RotorHazard/rhfiles/6_Node_BPill/case/img/RH_Lid_Wiring.jpg

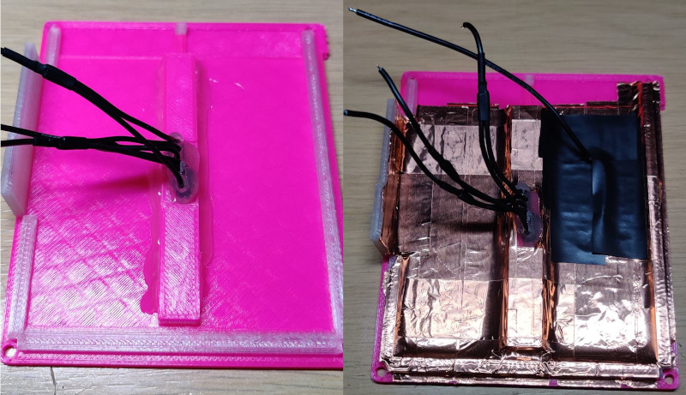
6_Node_BPill/case/img/RH_Lid_Wiring.jpg
