RotorHazard/rhfiles/S32_BPill/caseBuildPics/image006.jpg

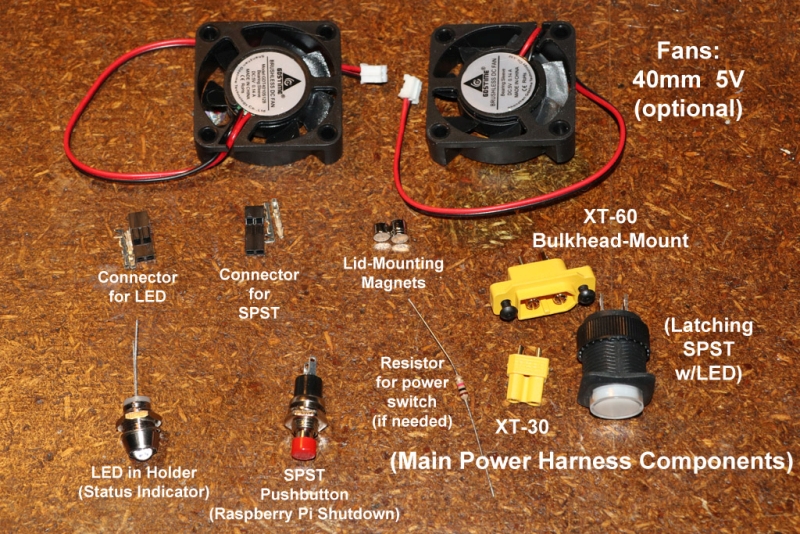
S32_BPill/caseBuildPics/image006.jpg
