RotorHazard/rhfiles/6_Node_BPill/case/img/RH_Cartridge_Slot.jpg

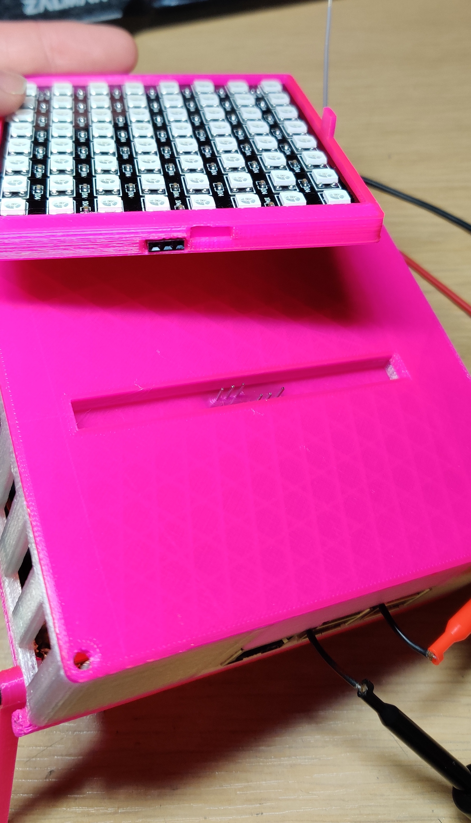
6_Node_BPill/case/img/RH_Cartridge_Slot.jpg
