RotorHazard/rhfiles/6_Node_BPill/case/img/RH_Case_Fold_Up.jpg

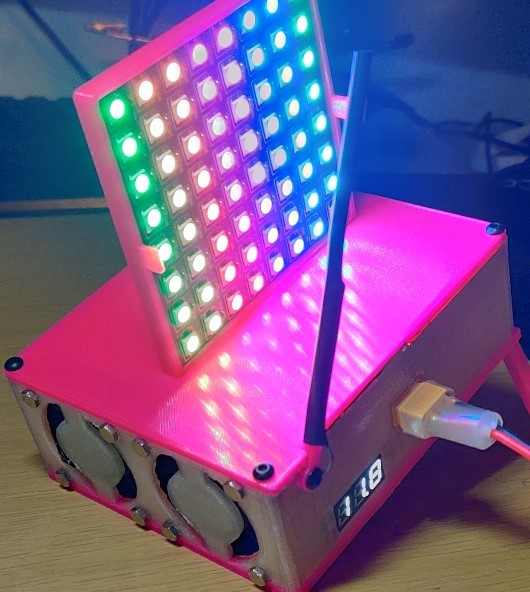
6_Node_BPill/case/img/RH_Case_Fold_Up.jpg
