RotorHazard/rhfiles/6_Node_BPill/case/img/RH_Case_Screen.jpg

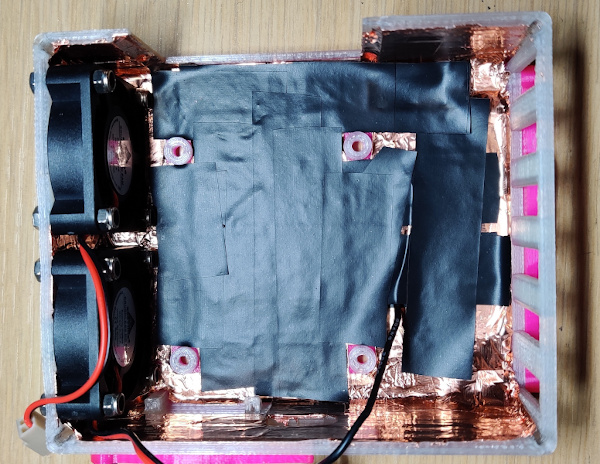
6_Node_BPill/case/img/RH_Case_Screen.jpg
