RotorHazard/rhfiles/6_Node_BPill/case/img/RH_Inside.jpg

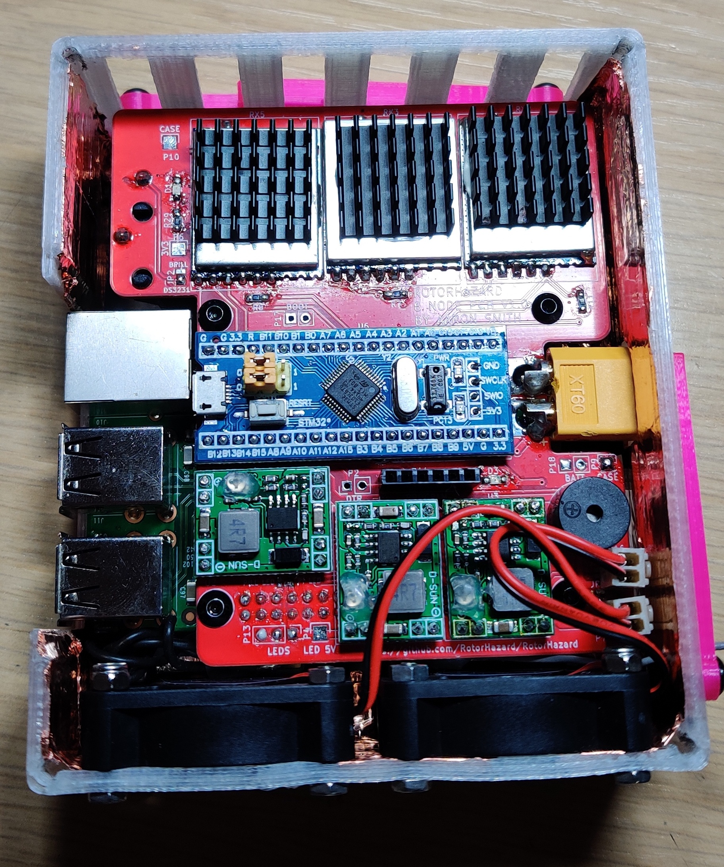
6_Node_BPill/case/img/RH_Inside.jpg
