RotorHazard/rhfiles/6_Node_BPill/case/img/RH_LED_Cartridge.jpg

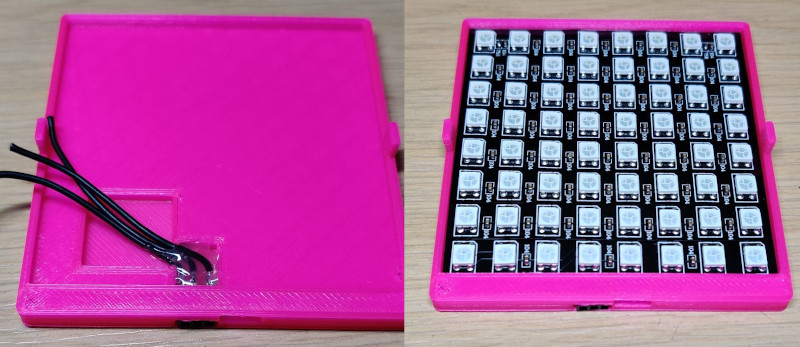
6_Node_BPill/case/img/RH_LED_Cartridge.jpg
