RotorHazard/rhfiles/6_Node_BPill/case/img/Wifi_Module.jpg

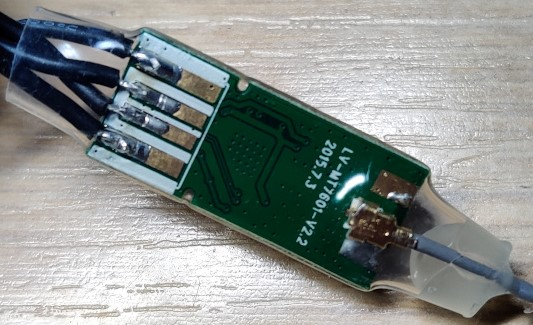
6_Node_BPill/case/img/Wifi_Module.jpg
