RotorHazard/rhfiles/S32_BPill/stm32f4pics/stm32f4_mod3.jpg

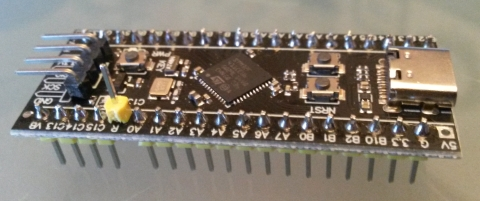
S32_BPill/stm32f4pics/stm32f4_mod3.jpg
