RotorHazard/rhfiles/6_Node_BPill/case/stl/RotorHazard_Standoff_M3_13.1mm.stl

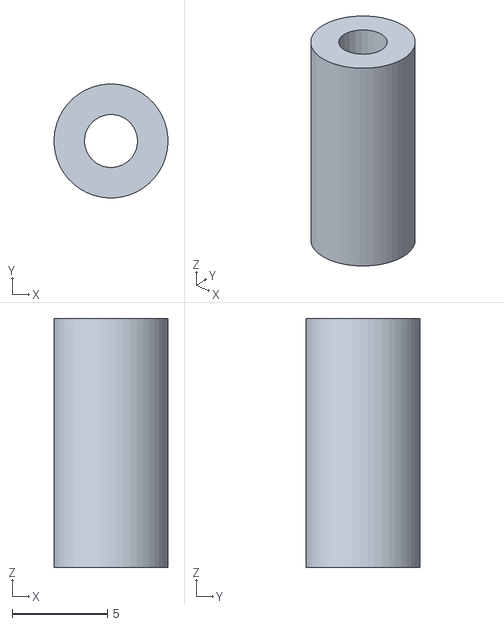
[picture p17: CAD file, 2021-04-22]
6_Node_BPill/case/stl/RotorHazard_Standoff_M3_13.1mm.stl
5.99 x 5.99 x 13.1
