RotorHazard/rhfiles/S32_BPill/case/RotorHazardCaseTopBDyy.stl

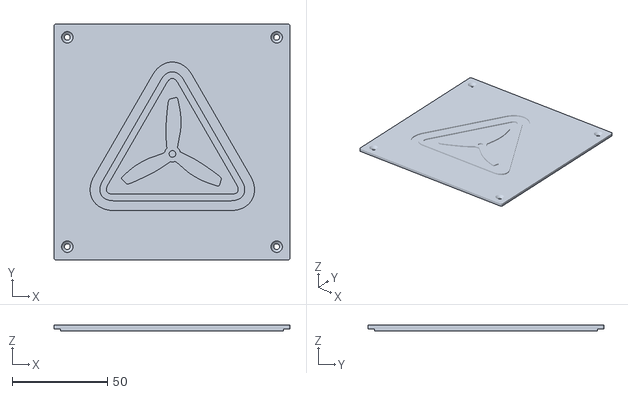
[picture p18: CAD file, 2021-02-14]
S32_BPill/case/RotorHazardCaseTopBDyy.stl
124.0 x 124.0 x 3.00
