RotorHazard/rhfiles/6_Node_BPill/case/stl/RotorHazard_Case - pi zero.stl

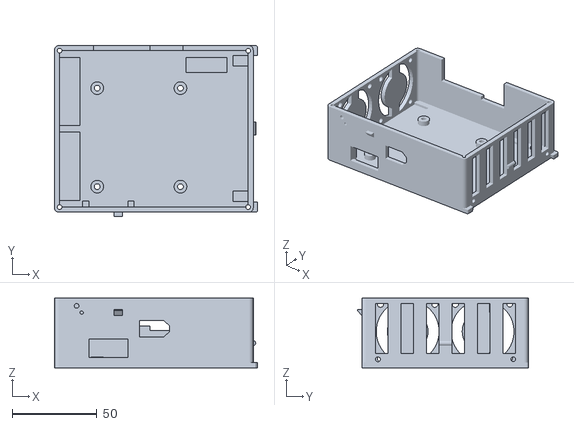
[picture p19: CAD file, 2021-04-22]
6_Node_BPill/case/stl/RotorHazard_Case - pi zero.stl
119.5 x 100.6 x 41.0
