RotorHazard/rhfiles/S32_BPill/case/RotorHazardCaseBDyy.FCStd

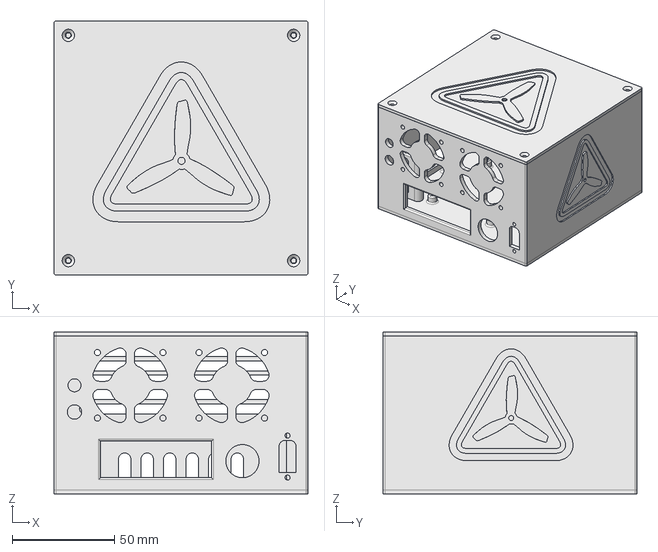
[picture p20: CAD file, 2021-02-14]
S32_BPill/case/RotorHazardCaseBDyy.FCStd
124.0 x 124.0 x 79.0 mm
CaseTop
