RotorHazard/rhfiles/6_Node_BPill/case/stl/RotorHazard_Antenna_Holder_50mm.stl

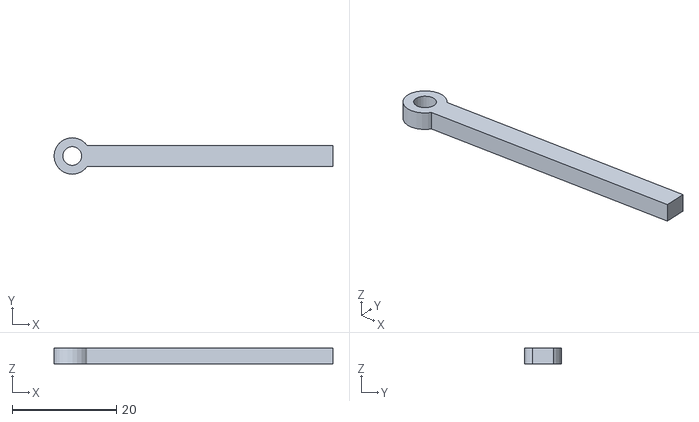
[picture p21: CAD file, 2021-03-14]
6_Node_BPill/case/stl/RotorHazard_Antenna_Holder_50mm.stl
53.5 x 7.00 x 3.00
