RotorHazard/rhfiles/6_Node_BPill/case/stl/RotorHazard_Standoff_M2.5_11.5mm.stl

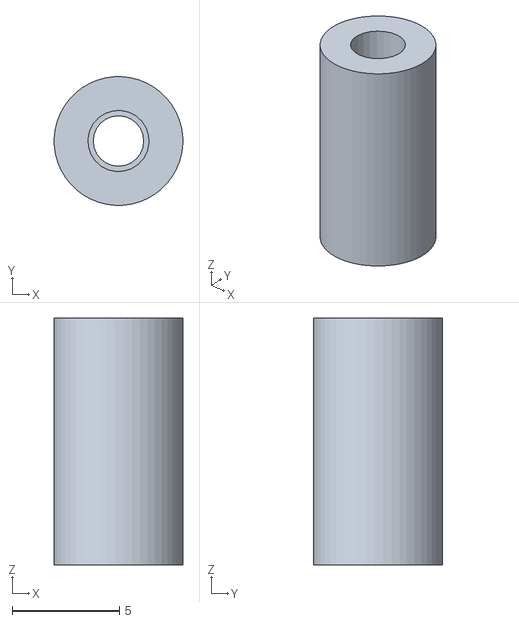
[picture p22: CAD file, 2021-03-14]
6_Node_BPill/case/stl/RotorHazard_Standoff_M2.5_11.5mm.stl
5.99 x 5.99 x 11.5
