RotorHazard/rhfiles/6_Node_BPill/case/stl/RotorHazard_LED_Cartridge.stl

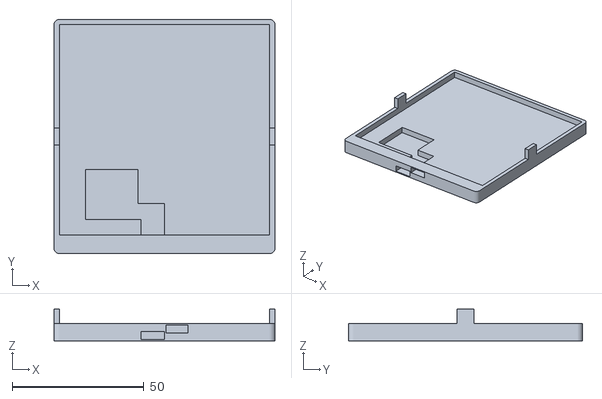
[picture p24: CAD file, 2021-03-14]
6_Node_BPill/case/stl/RotorHazard_LED_Cartridge.stl
84.0 x 89.0 x 12.0
