RotorHazard/rhfiles/6_Node_BPill/case/stl/RotorHazard_Lid_Cartridge_2part_A.stl

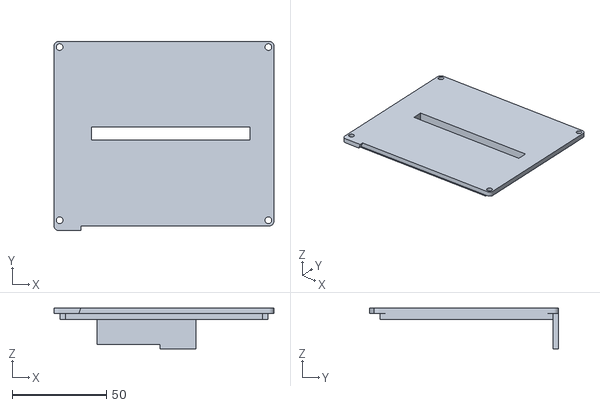
[picture p25: CAD file, 2021-03-14]
6_Node_BPill/case/stl/RotorHazard_Lid_Cartridge_2part_A.stl
117.0 x 100.6 x 21.8
