RotorHazard/rhfiles/6_Node_BPill/case/stl/RotorHazard_Case.stl

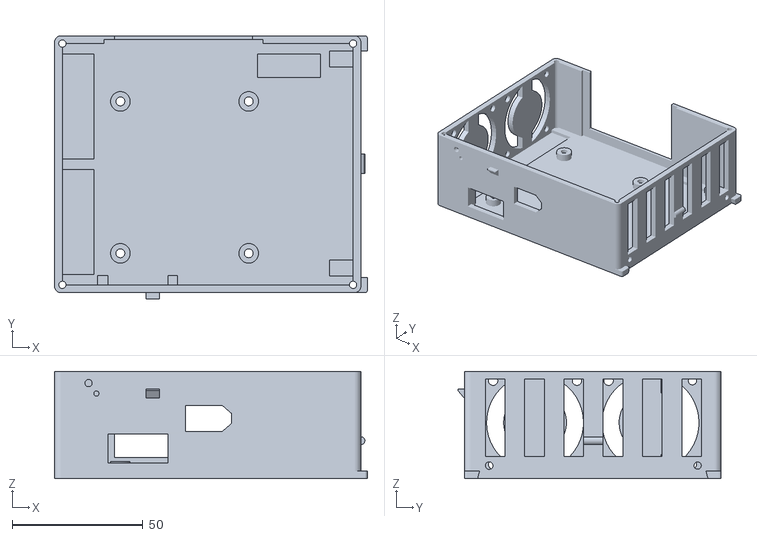
[picture p26: CAD file, 2021-03-14]
6_Node_BPill/case/stl/RotorHazard_Case.stl
119.5 x 100.6 x 41.0
