RotorHazard/rhfiles/6_Node_BPill/case/stl/RotorHazard_Leg_60mm.stl

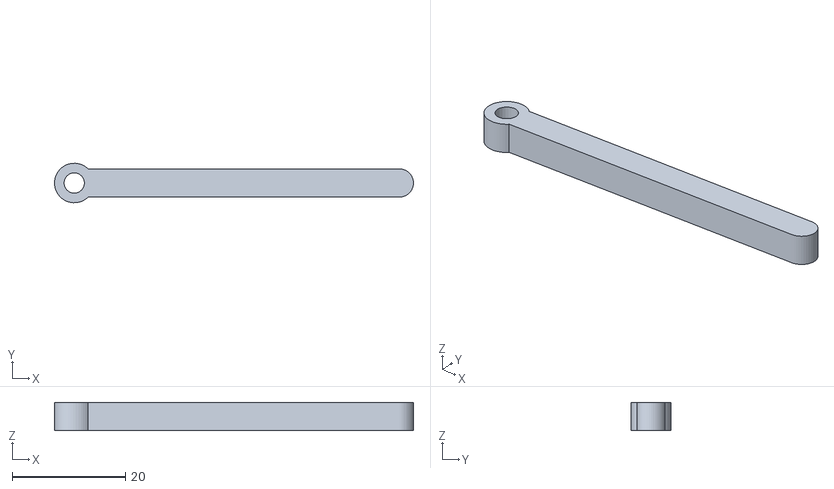
[picture p27: CAD file, 2021-03-14]
6_Node_BPill/case/stl/RotorHazard_Leg_60mm.stl
63.5 x 6.99 x 5.00
