RotorHazard/rhfiles/6_Node_BPill/case/stl/RotorHazard_Lid_Cartridge_2part_B.stl

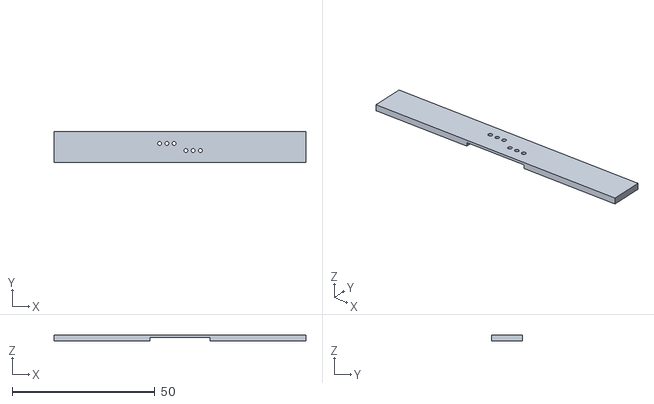
[picture p28: CAD file, 2021-03-14]
6_Node_BPill/case/stl/RotorHazard_Lid_Cartridge_2part_B.stl
88.4 x 10.9 x 2.00
