RotorHazard/rhfiles/(list of files, cad)

Other CAD files:
6_Node_BPill/case/stl/RotorHazard_Lid_External_LEDs.stl
6_Node_BPill/case/stl/RotorHazard_Lid_No_LEDs.stl
6_Node_BPill/case/stl/RotorHazard_Standoff_M3_11.5mm.stl
6_Node_BPill/case/skp/RotorHazard_Antenna_Holder_50mm.skp
6_Node_BPill/case/skp/RotorHazard_Case - pi zero.skp
6_Node_BPill/case/skp/RotorHazard_Case.skp
6_Node_BPill/case/skp/RotorHazard_LED_Cartridge.skp
6_Node_BPill/case/skp/RotorHazard_Leg_60mm.skp
6_Node_BPill/case/skp/RotorHazard_Lid_Cartridge_1part.skp
6_Node_BPill/case/skp/RotorHazard_Lid_Cartridge_2part_A.skp
6_Node_BPill/case/skp/RotorHazard_Lid_Cartridge_2part_B.skp
6_Node_BPill/case/skp/RotorHazard_Lid_External_LEDs.skp
6_Node_BPill/case/skp/RotorHazard_Lid_No_LEDs.skp
6_Node_BPill/case/skp/RotorHazard_Standoff_M2.5_11.5mm.skp
6_Node_BPill/case/skp/RotorHazard_Standoff_M3_11.5mm.skp
6_Node_BPill/case/skp/RotorHazard_Standoff_M3_13.1mm.skp
