RotorHazard/rhfiles/6_Node_BPill/PCBBuildPics/6_Node_STM32_PCB_Top.jpg

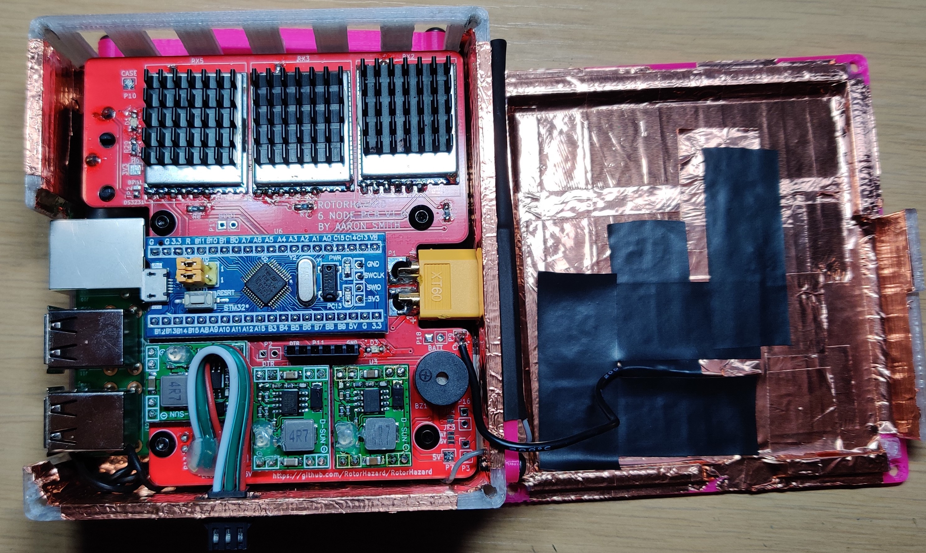
6_Node_BPill/PCBBuildPics/6_Node_STM32_PCB_Top.jpg
