RotorHazard/rhfiles/6_Node_BPill/PCBBuildPics/RH6_Node_PCB_Step1.png

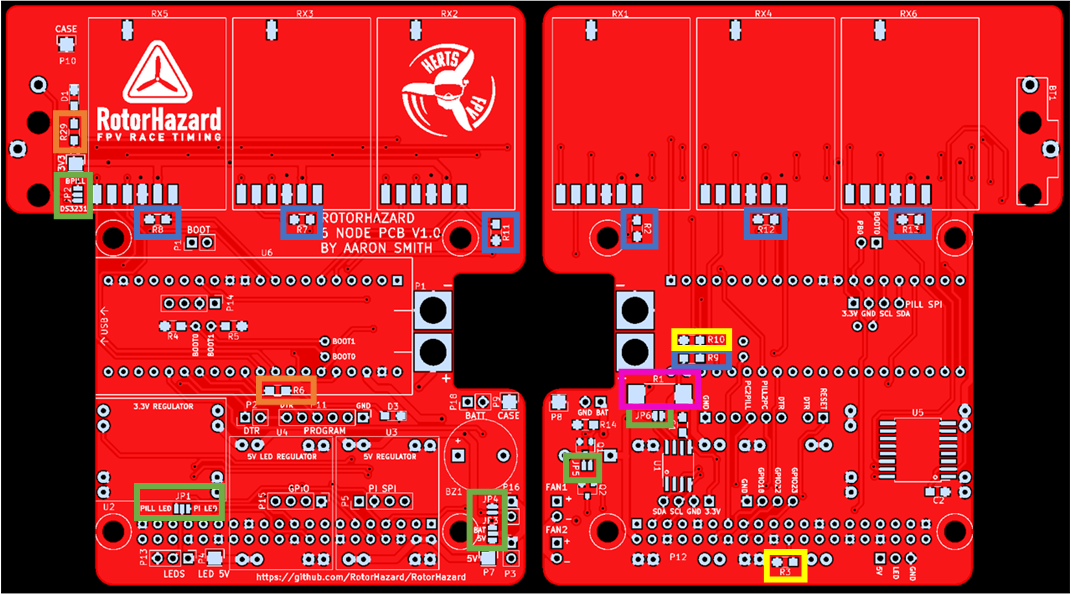
6_Node_BPill/PCBBuildPics/RH6_Node_PCB_Step1.png
