RotorHazard/rhfiles/S32_BPill/caseBuildPics/image004.jpg

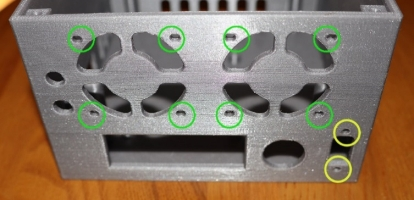
S32_BPill/caseBuildPics/image004.jpg
