RotorHazard/rhfiles/S32_BPill/caseBuildPics/image009.jpg

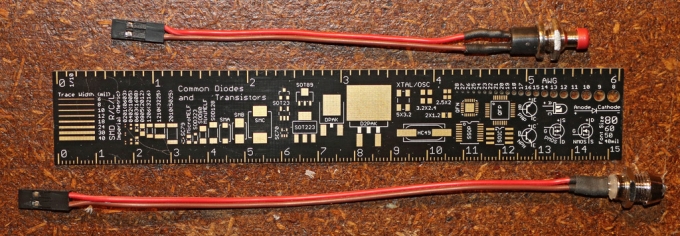
S32_BPill/caseBuildPics/image009.jpg
