RotorHazard/rhfiles/S32_BPill/mainBuildPics/image1.jpg

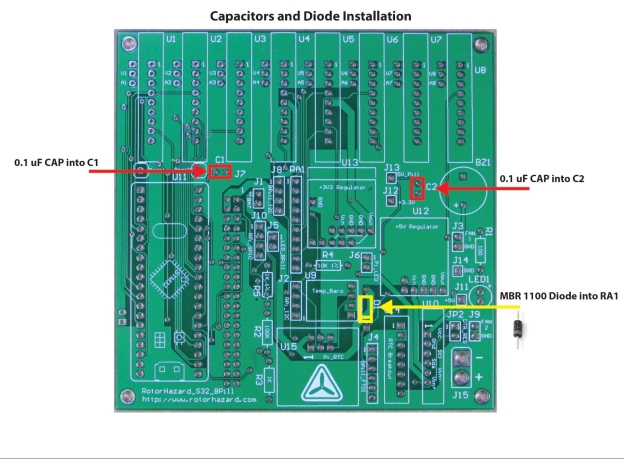
S32_BPill/mainBuildPics/image1.jpg
