RotorHazard/rhfiles/S32_BPill/mainBuildPics/image3.jpg

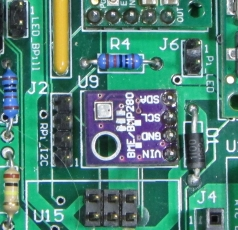
S32_BPill/mainBuildPics/image3.jpg
