RotorHazard/rhfiles/S32_BPill/mainBuildPics/image6.jpg

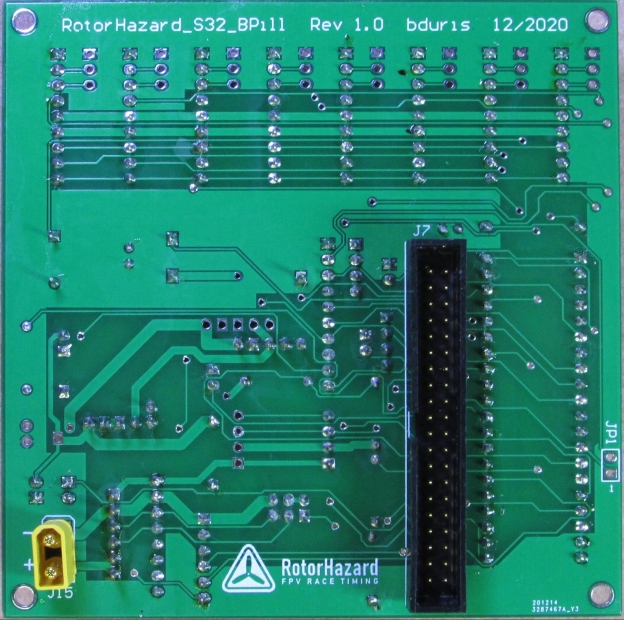
S32_BPill/mainBuildPics/image6.jpg
