RotorHazard/rhfiles/S32_BPill/mainBuildPics/image8.jpg

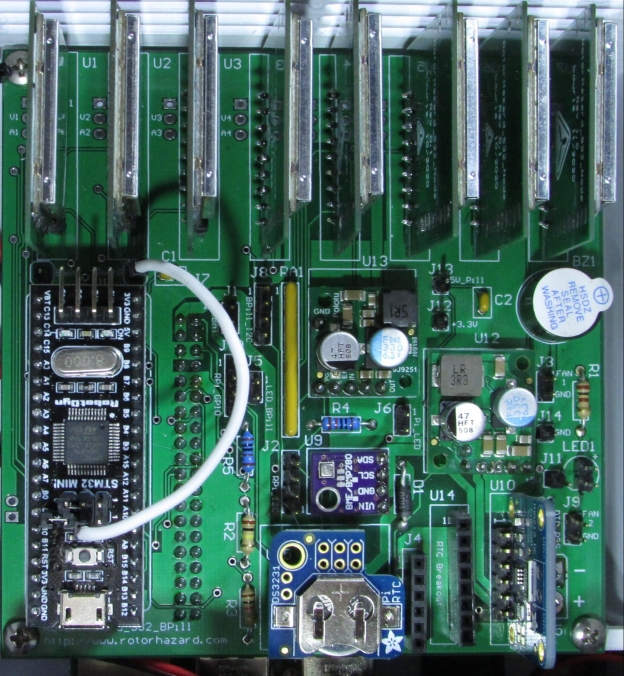
S32_BPill/mainBuildPics/image8.jpg
