RotorHazard/rhfiles/S32_BPill/mainBuildPics/image9.jpg

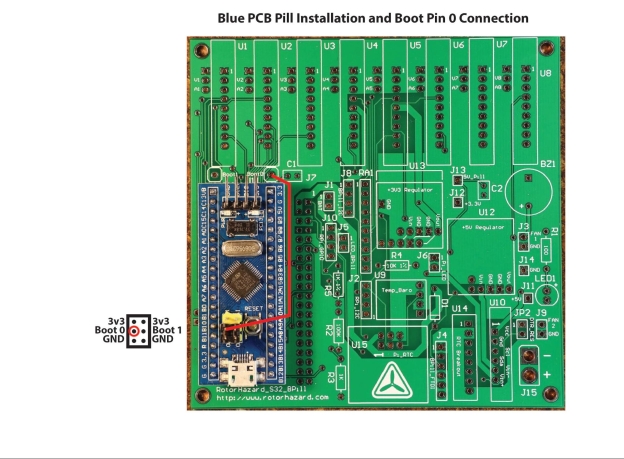
S32_BPill/mainBuildPics/image9.jpg
