RotorHazard/rhfiles/S32_BPill/mainBuildPics/image10.jpg

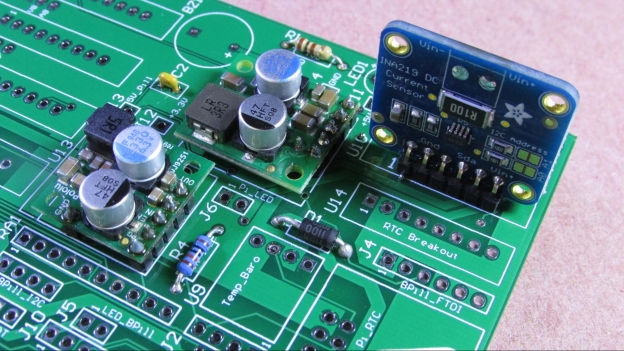
S32_BPill/mainBuildPics/image10.jpg
