RotorHazard/rhfiles/S32_BPill/mainBuildPics/image11.jpg

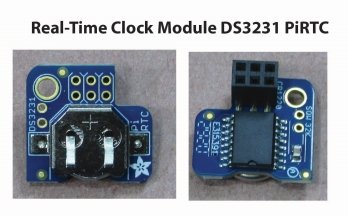
S32_BPill/mainBuildPics/image11.jpg
