RotorHazard/rhfiles/S32_BPill/mainBuildPics/image12.jpg

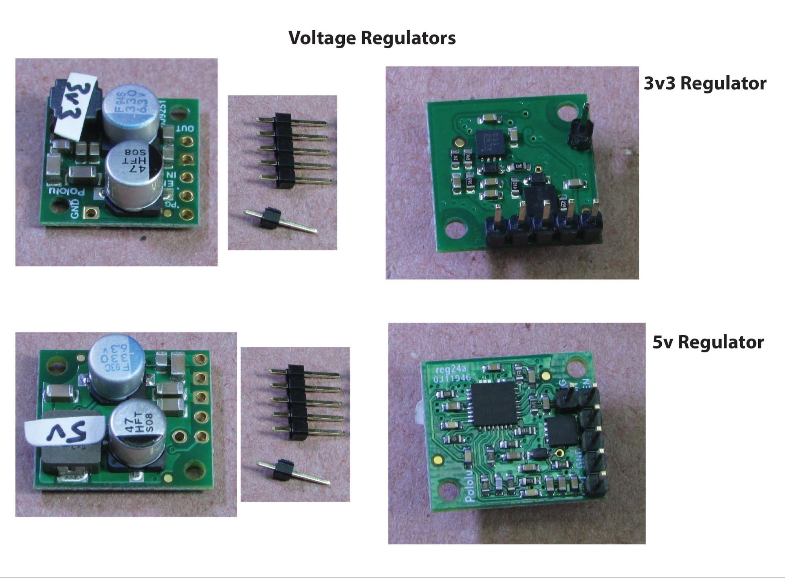
S32_BPill/mainBuildPics/image12.jpg
