RotorHazard/rhfiles/S32_BPill/mainBuildPics/image13.jpg

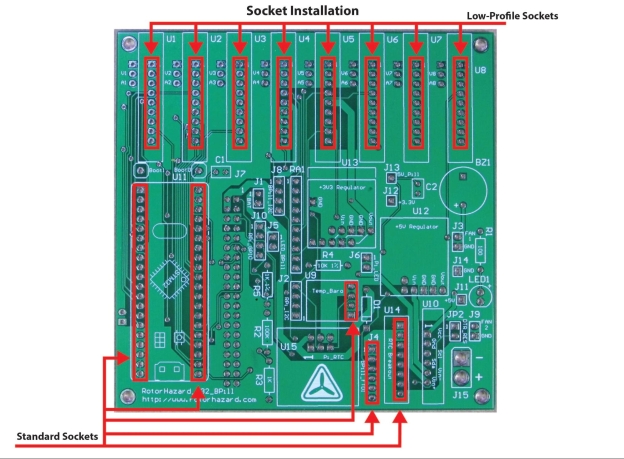
S32_BPill/mainBuildPics/image13.jpg
