RotorHazard/rhfiles/S32_BPill/mainBuildPics/image16.jpg

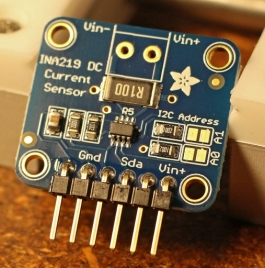
S32_BPill/mainBuildPics/image16.jpg
