RotorHazard/rhfiles/S32_BPill/mainBuildPics/image17.png

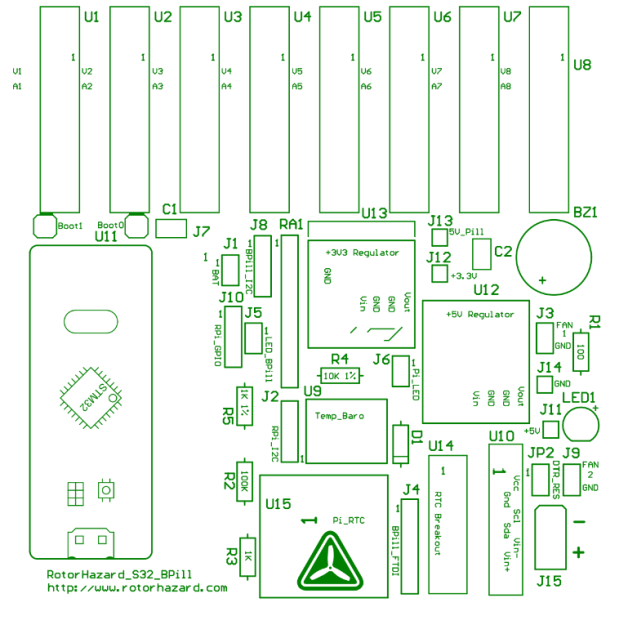
S32_BPill/mainBuildPics/image17.png
