RotorHazard/rhfiles/S32_BPill/mainBuildPics/image18.jpg

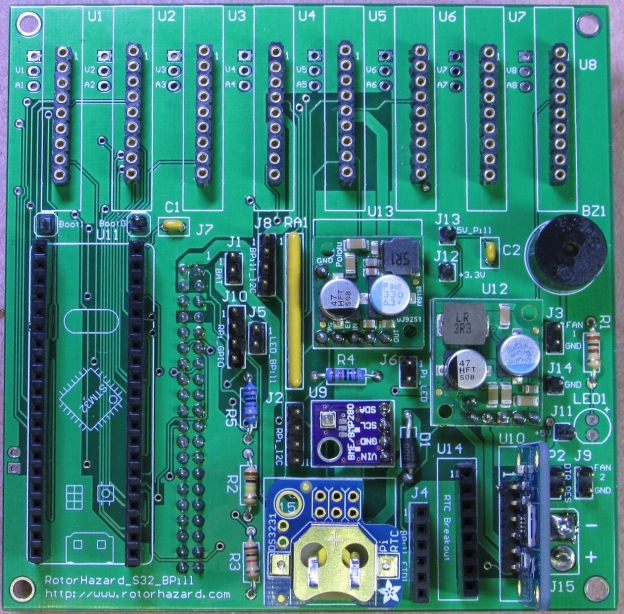
S32_BPill/mainBuildPics/image18.jpg
