RotorHazard/rhfiles/S32_BPill/nodeBuildPics/image1.jpg

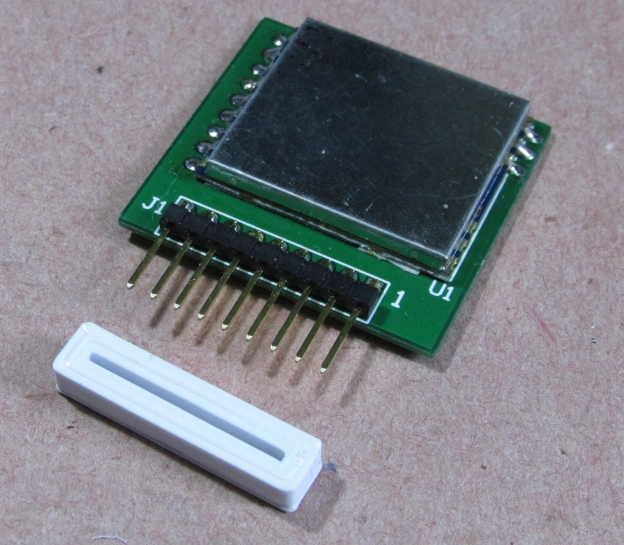
S32_BPill/nodeBuildPics/image1.jpg
