RotorHazard/rhfiles/S32_BPill/nodeBuildPics/image2.jpg

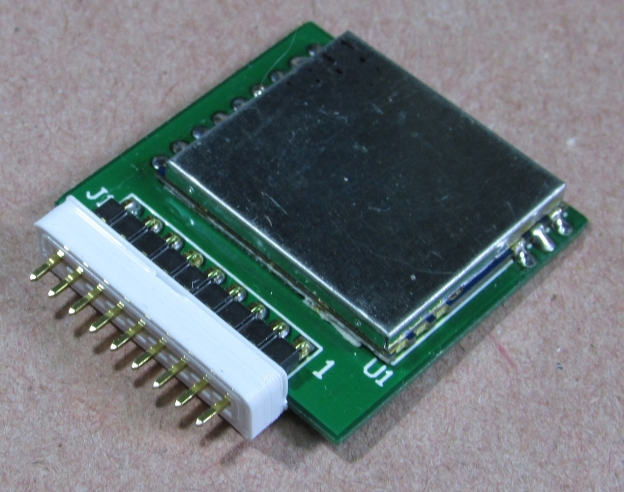
S32_BPill/nodeBuildPics/image2.jpg
