RotorHazard/rhfiles/S32_BPill/nodeBuildPics/image3.jpg

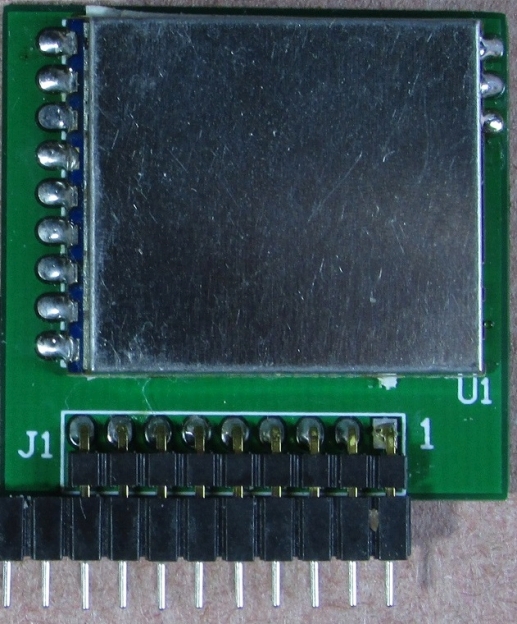
S32_BPill/nodeBuildPics/image3.jpg
