RotorHazard/rhfiles/S32_BPill/nodeBuildPics/image4.jpg

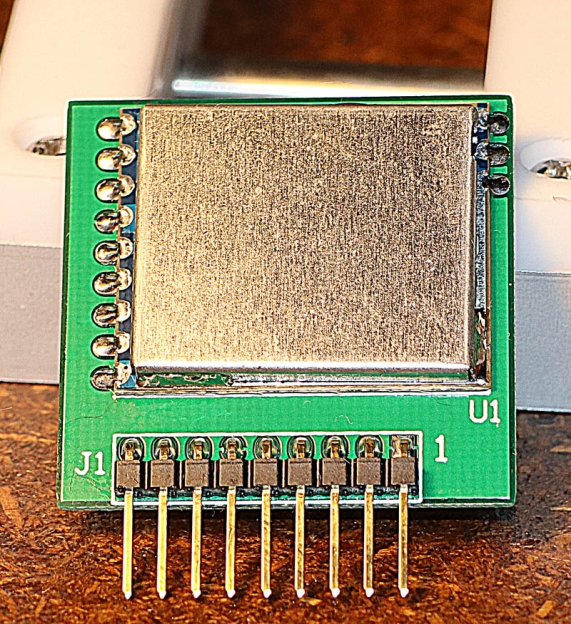
S32_BPill/nodeBuildPics/image4.jpg
