RotorHazard/rhfiles/S32_BPill/nodeBuildPics/image5.jpg

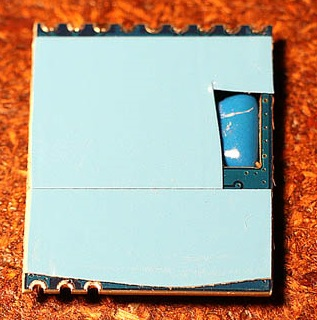
S32_BPill/nodeBuildPics/image5.jpg
