RotorHazard/rhfiles/S32_BPill/nodeBuildPics/image6.jpg

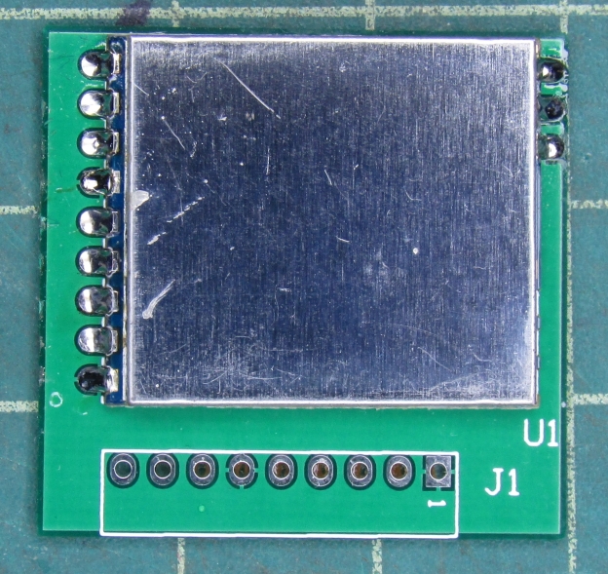
S32_BPill/nodeBuildPics/image6.jpg
