RotorHazard/rhfiles/S32_BPill/nodeBuildPics/image7.jpg

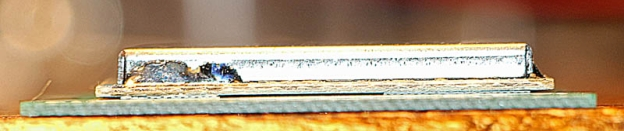
S32_BPill/nodeBuildPics/image7.jpg
