RotorHazard/rhfiles/S32_BPill/nodeBuildPics/image8.jpg

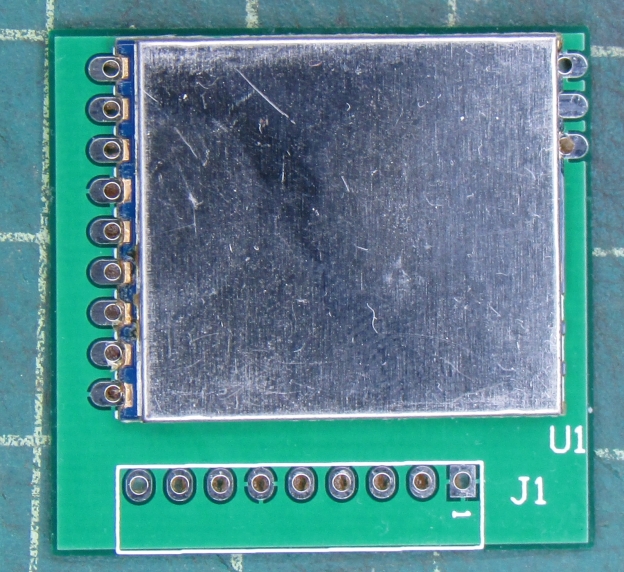
S32_BPill/nodeBuildPics/image8.jpg
