RotorHazard/rhfiles/S32_BPill/nodeBuildPics/image9.jpg

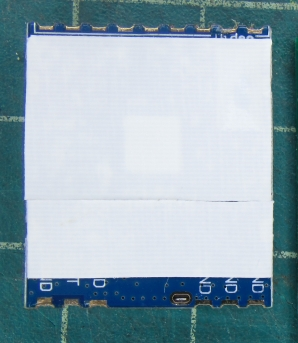
S32_BPill/nodeBuildPics/image9.jpg
