RotorHazard/rhfiles/S32_BPill/nodeBuildPics/image10.jpg

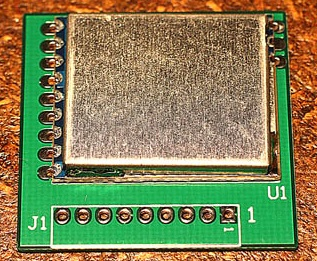
S32_BPill/nodeBuildPics/image10.jpg
