RotorHazard/rhfiles/S32_BPill/nodeBuildPics/image11.jpg

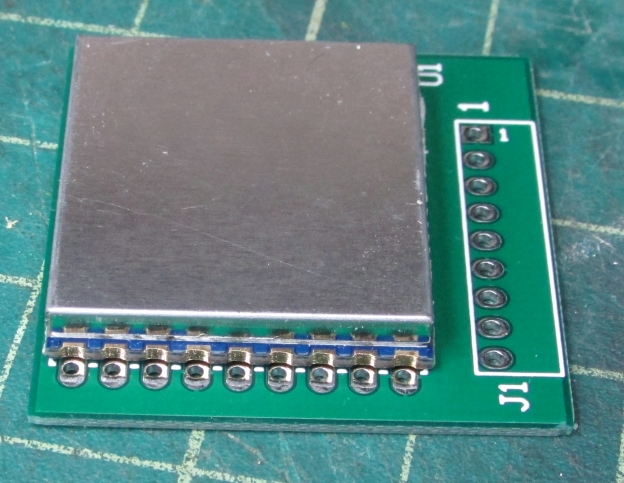
S32_BPill/nodeBuildPics/image11.jpg
