RotorHazard/rhfiles/S32_BPill/nodeBuildPics/image12.jpg

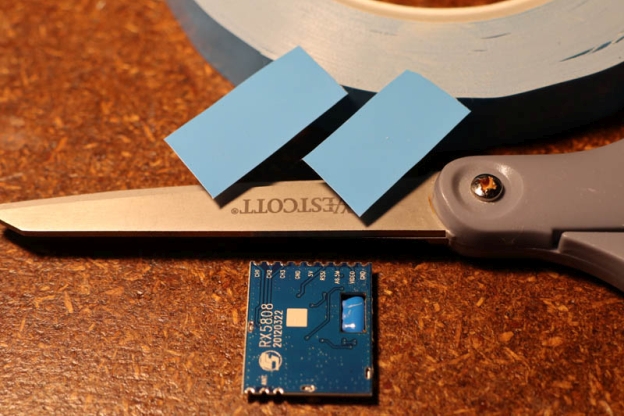
S32_BPill/nodeBuildPics/image12.jpg
