RotorHazard/rhfiles/S32_BPill/files/RotorHazard_S32_Node_PCB_R1_0.pdf

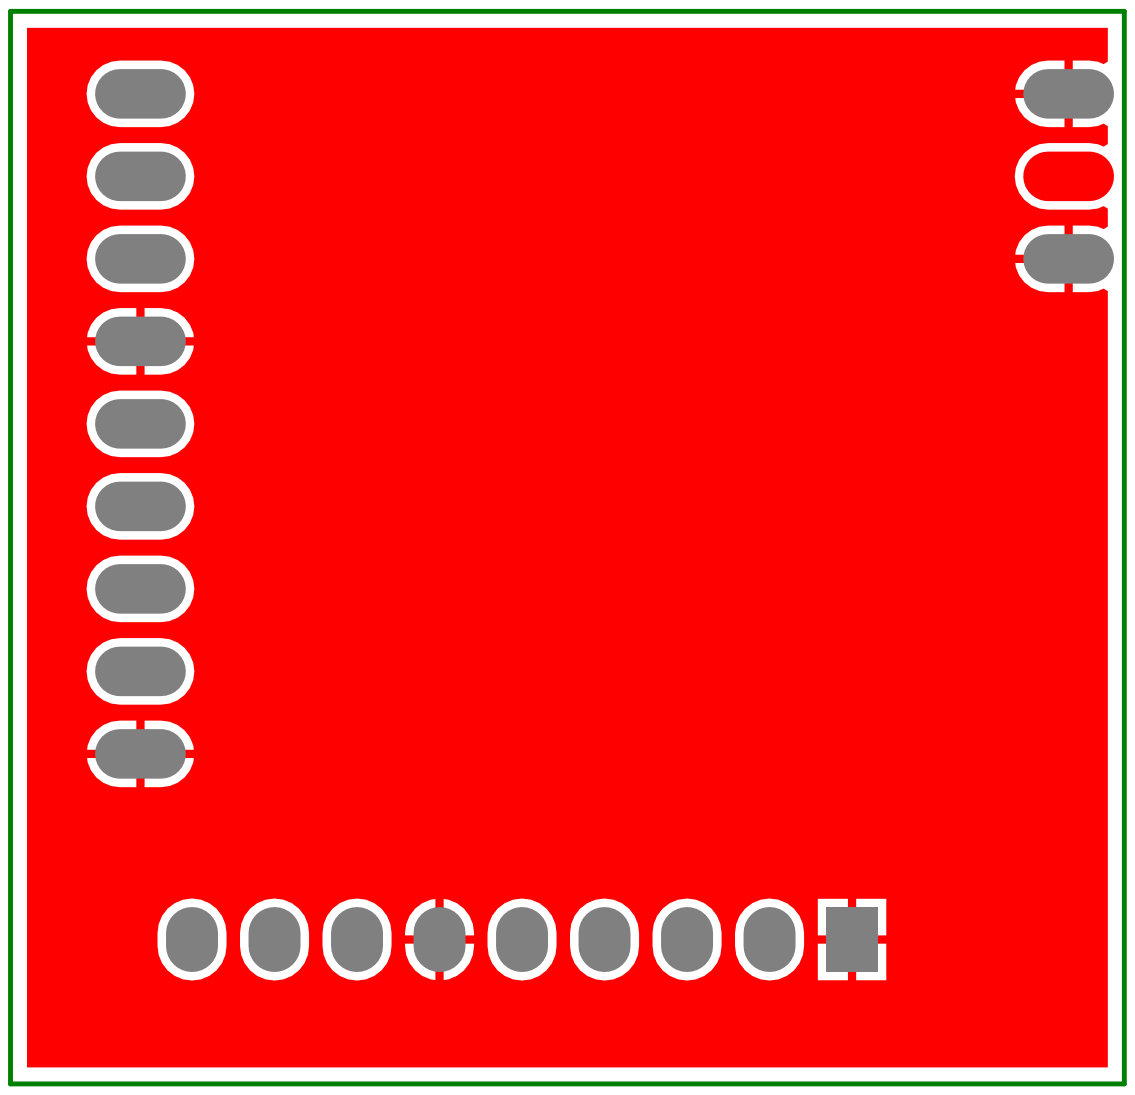
[picture p78: page 1]

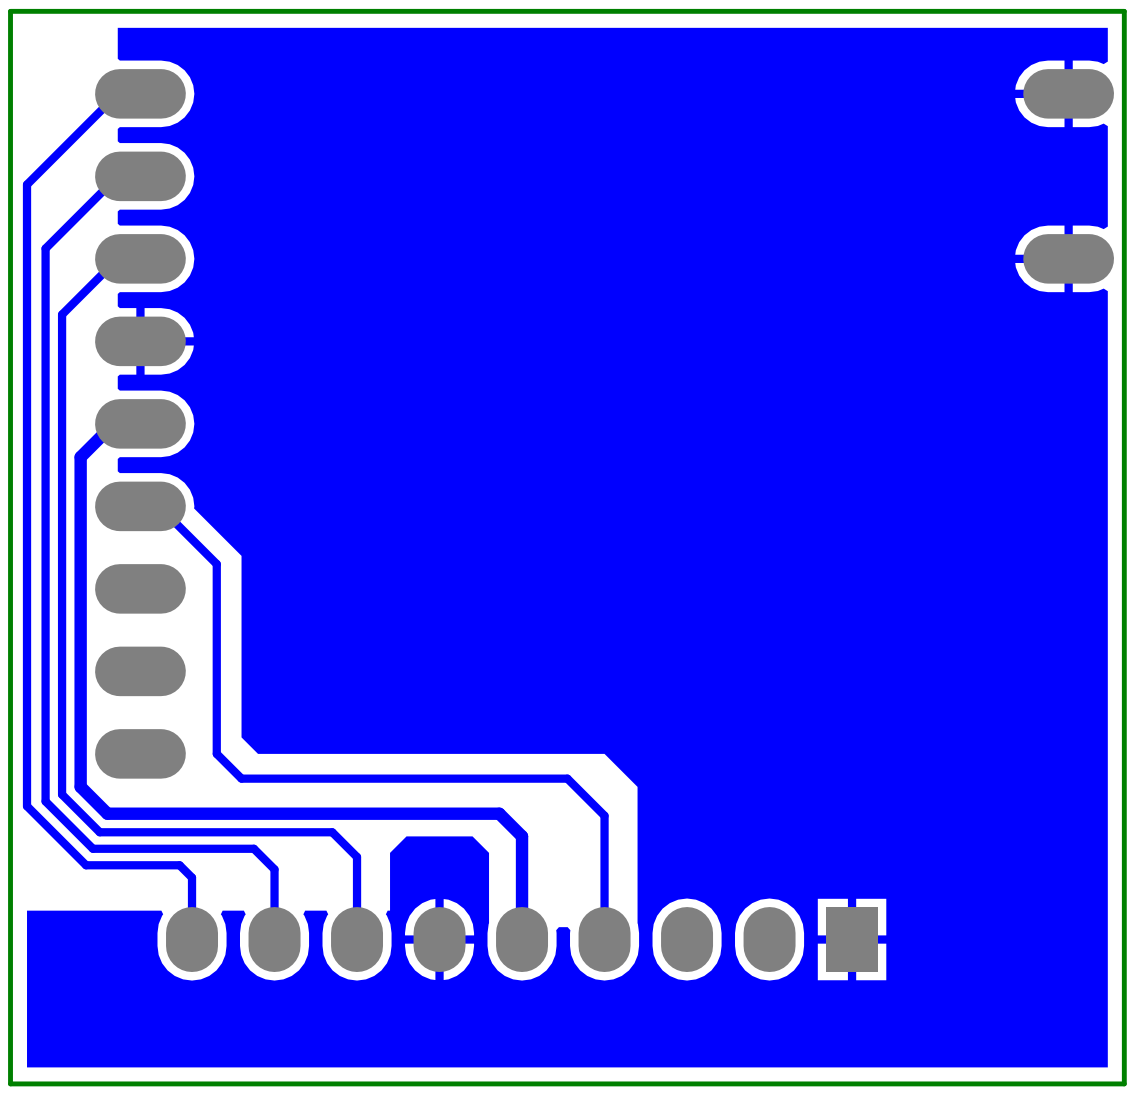
[picture p79: page 2]

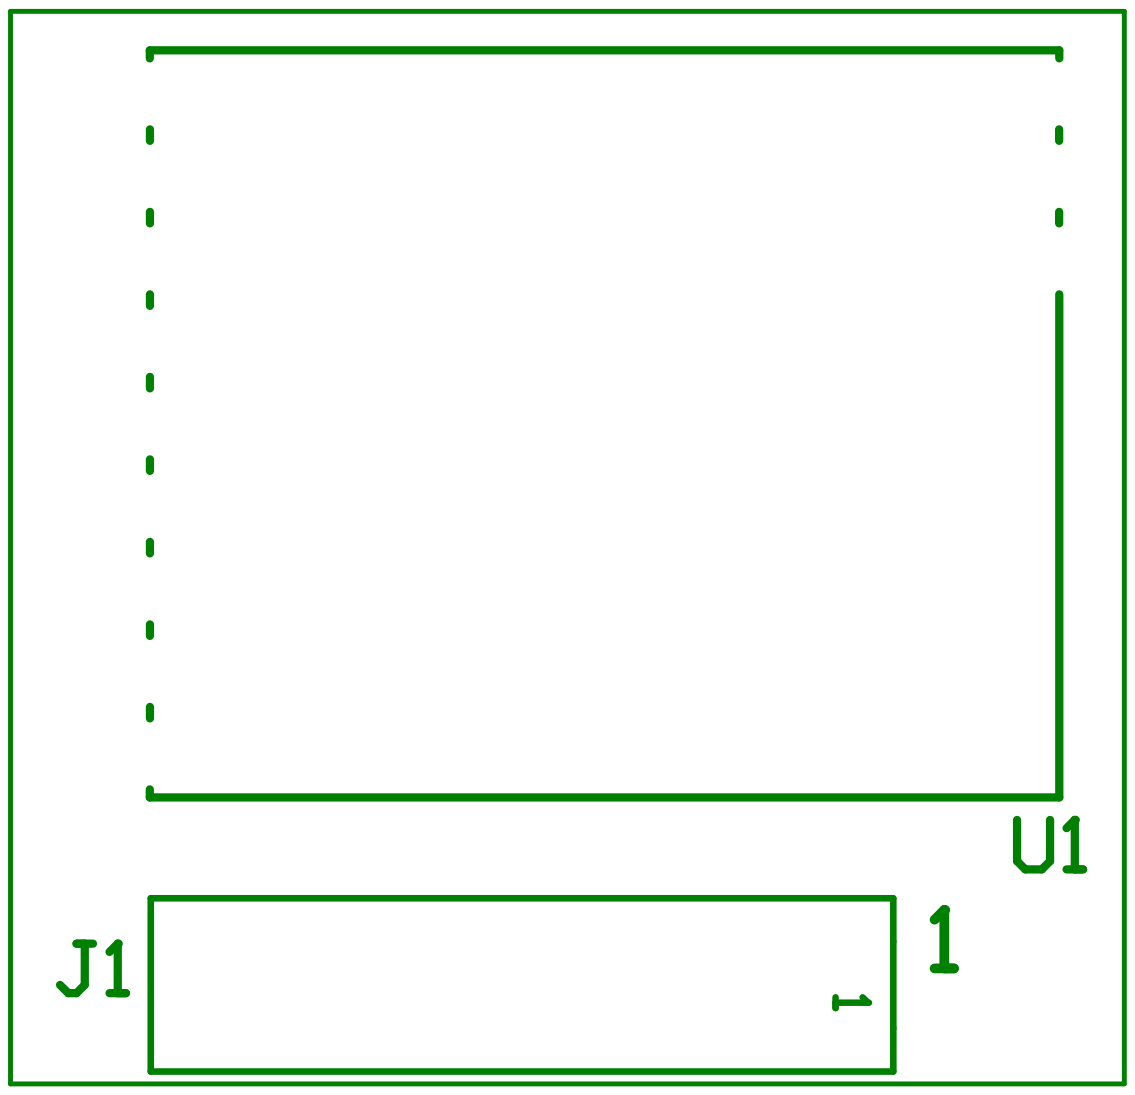
[picture p80: page 3]

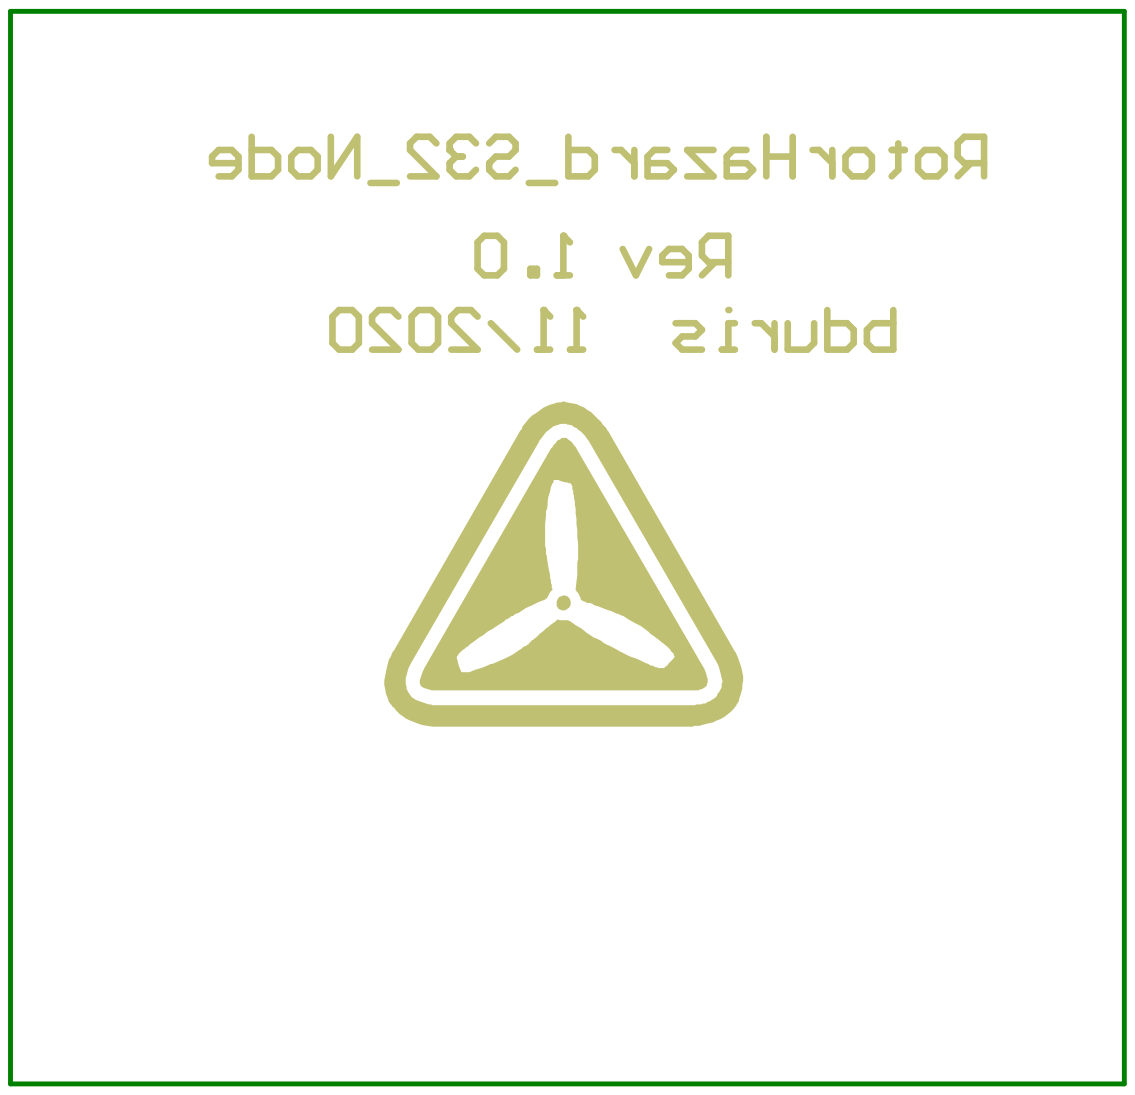
[picture p81: page 4]

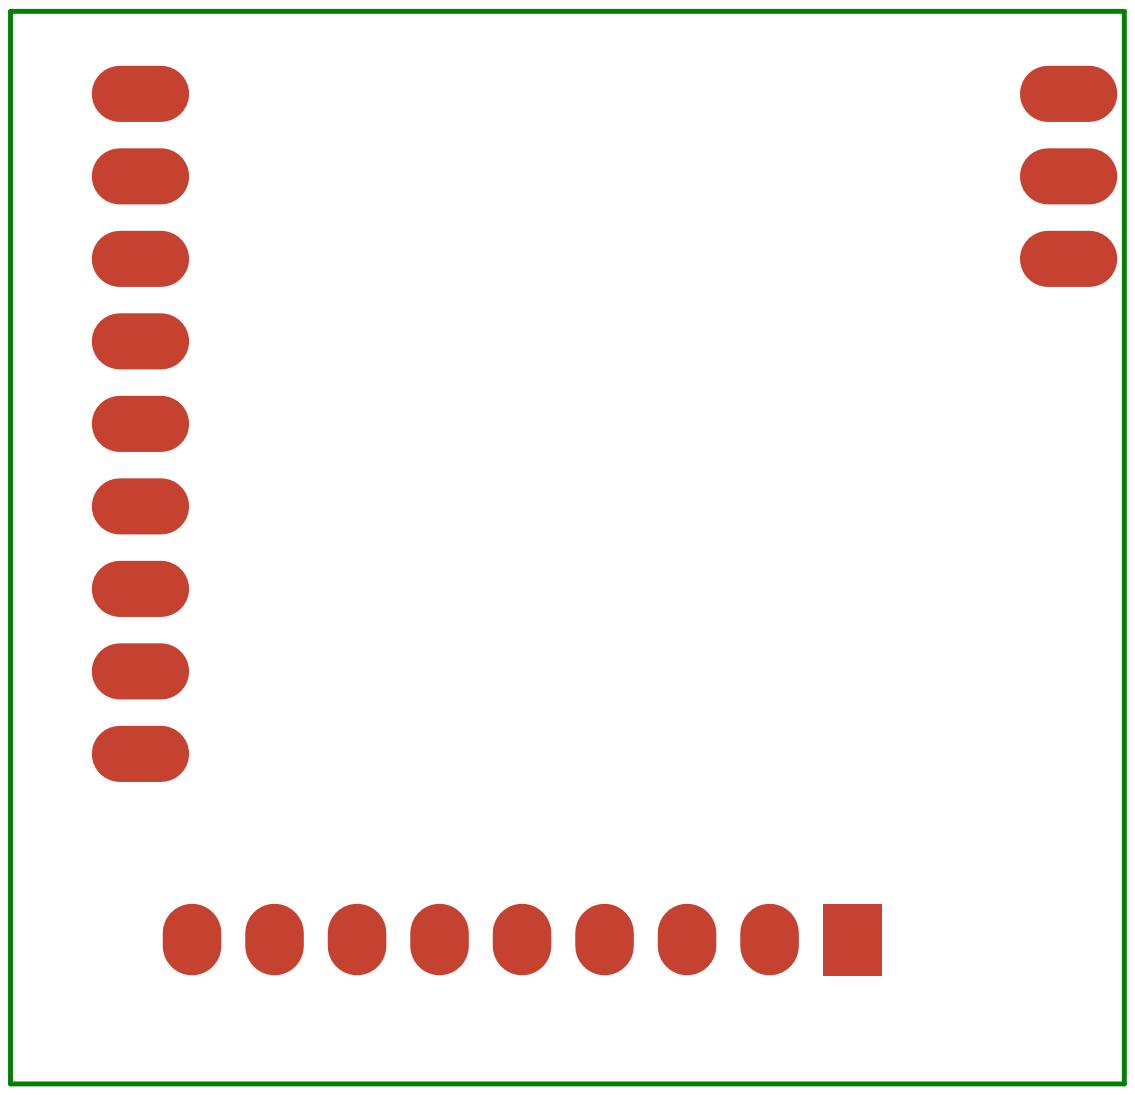
[picture p82: page 5]

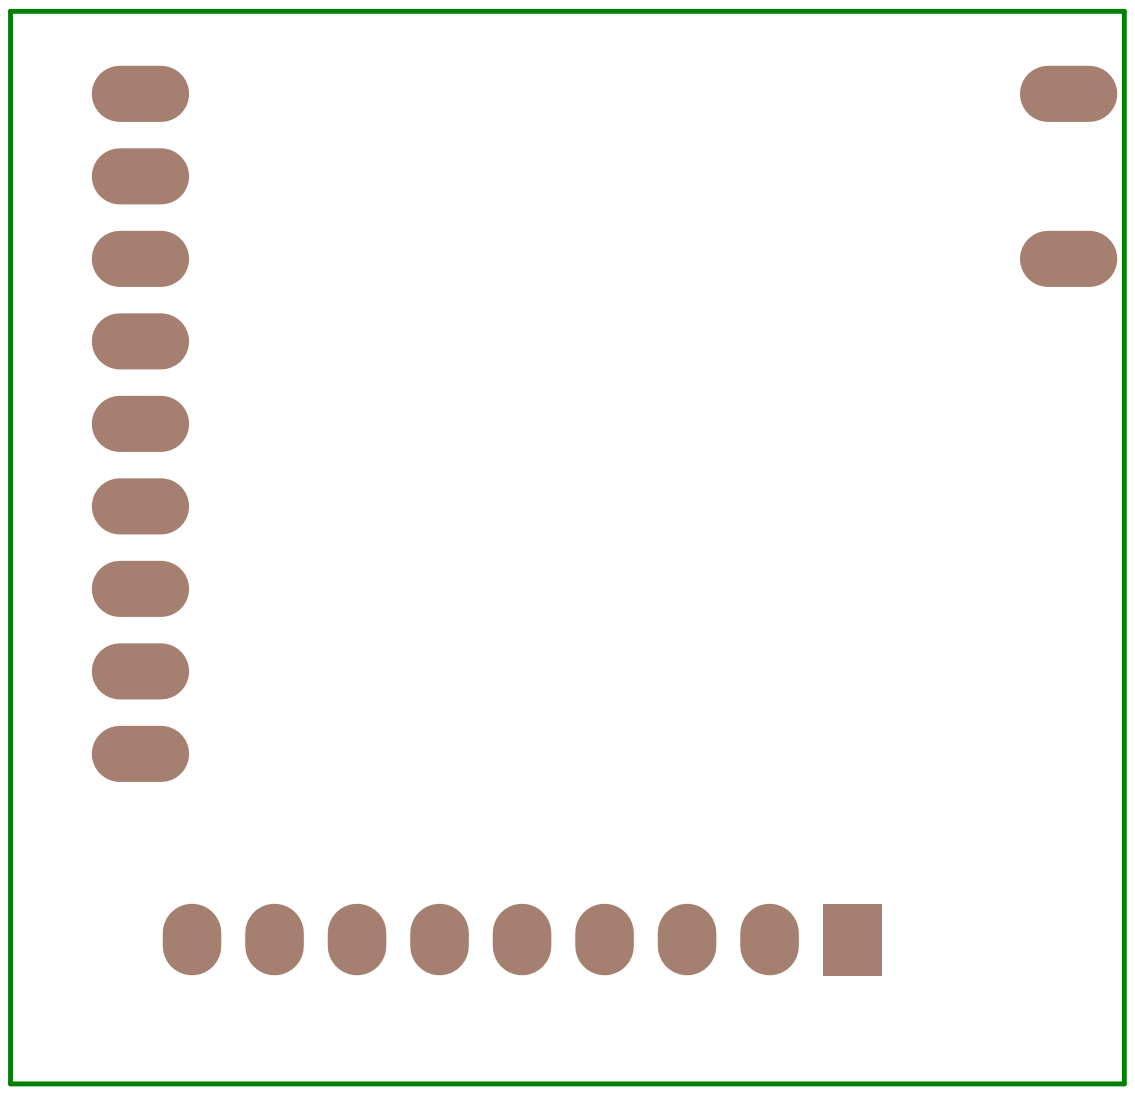
[picture p83: page 6]

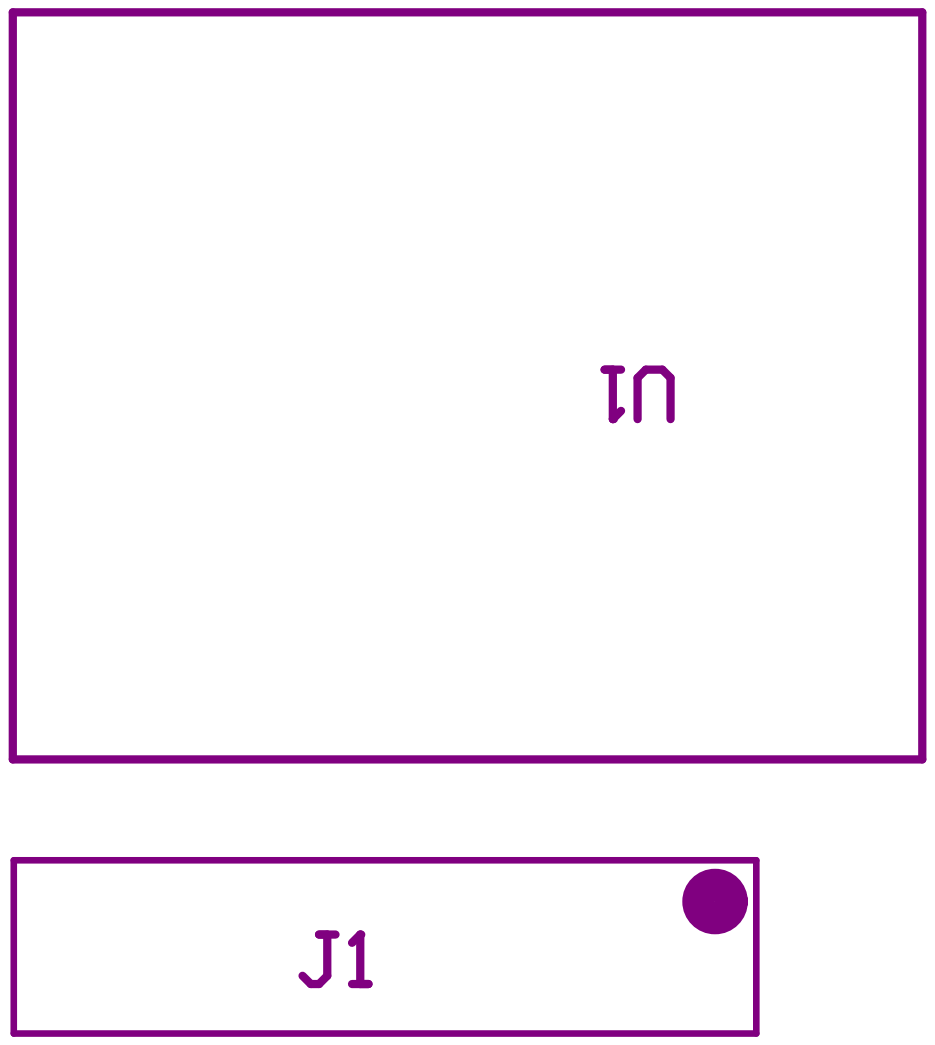
[picture p84: page 9]

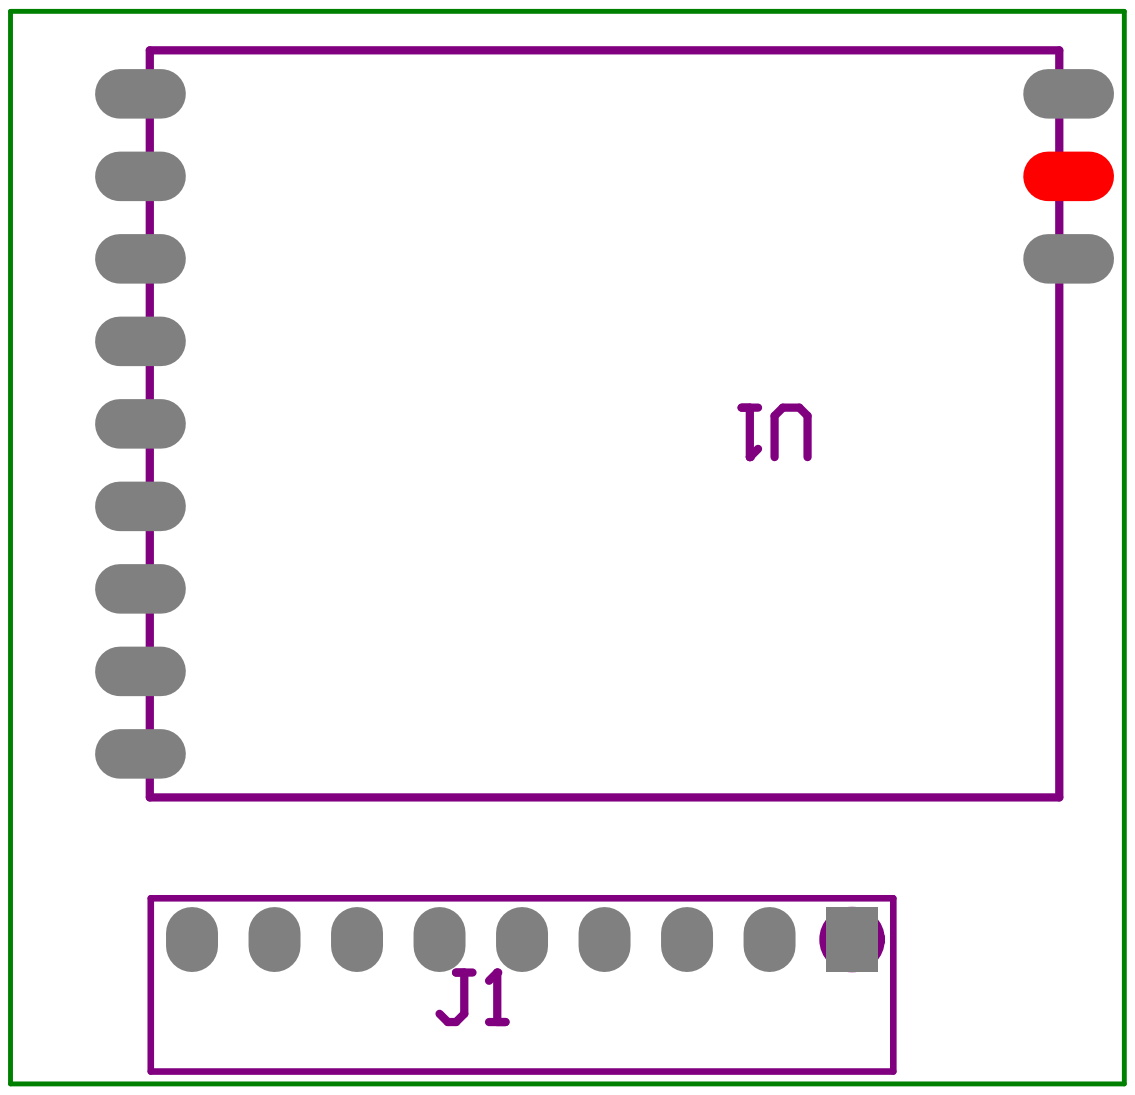
[picture p85: page 10]

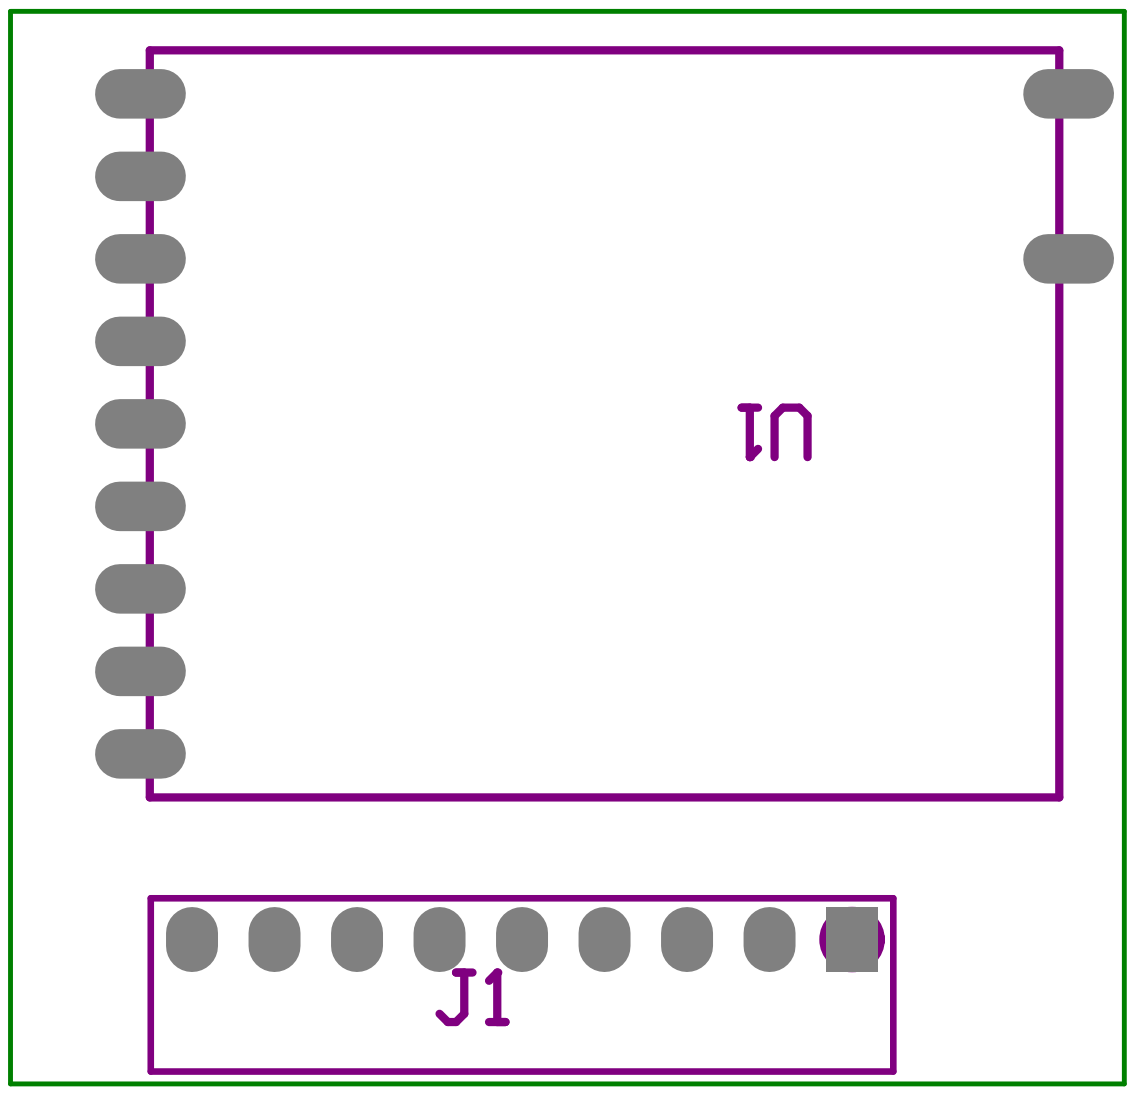
[picture p86: page 11]

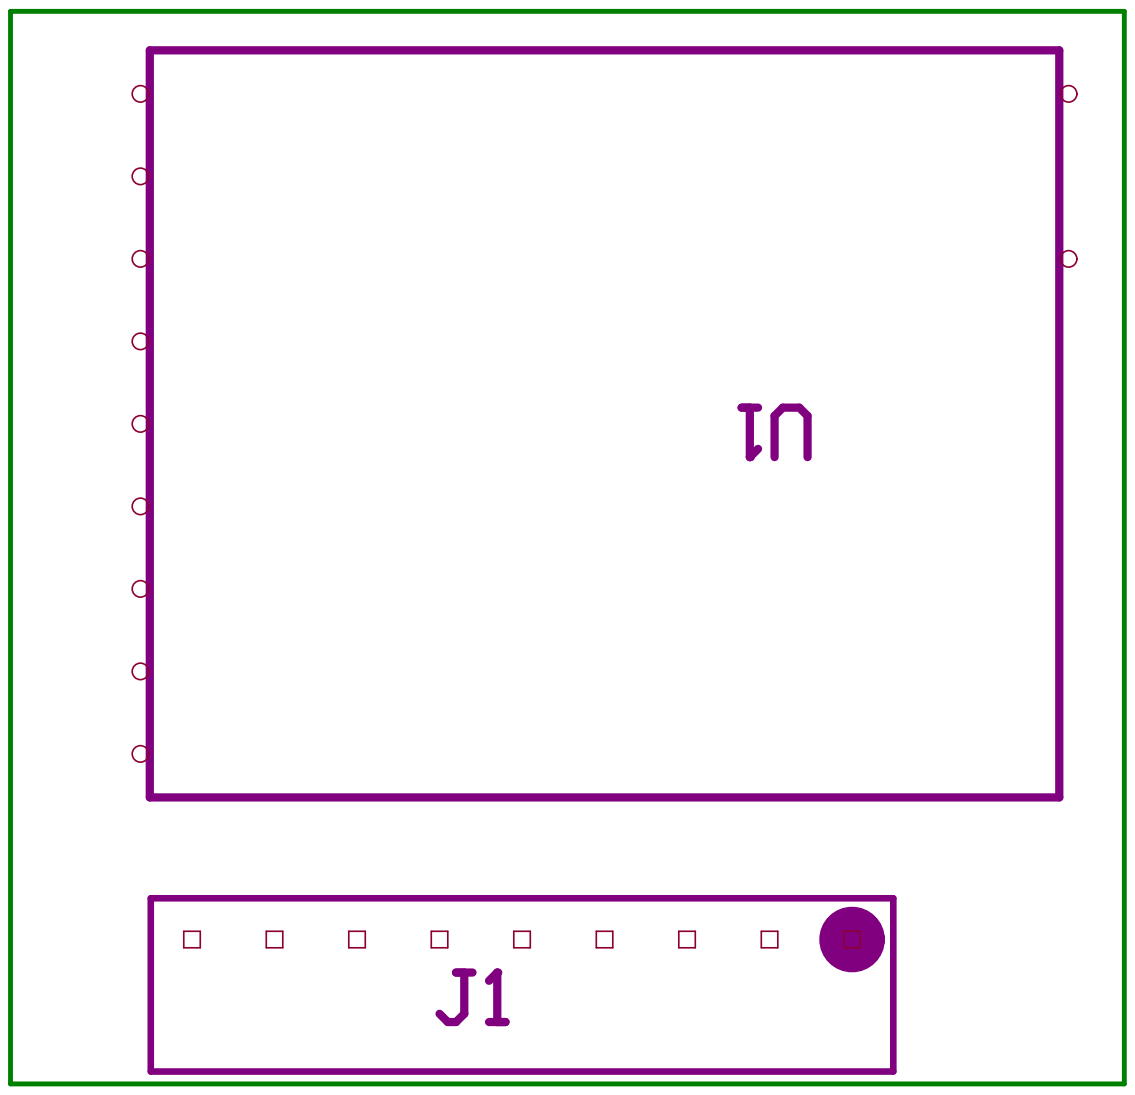
[picture p87: page 12]

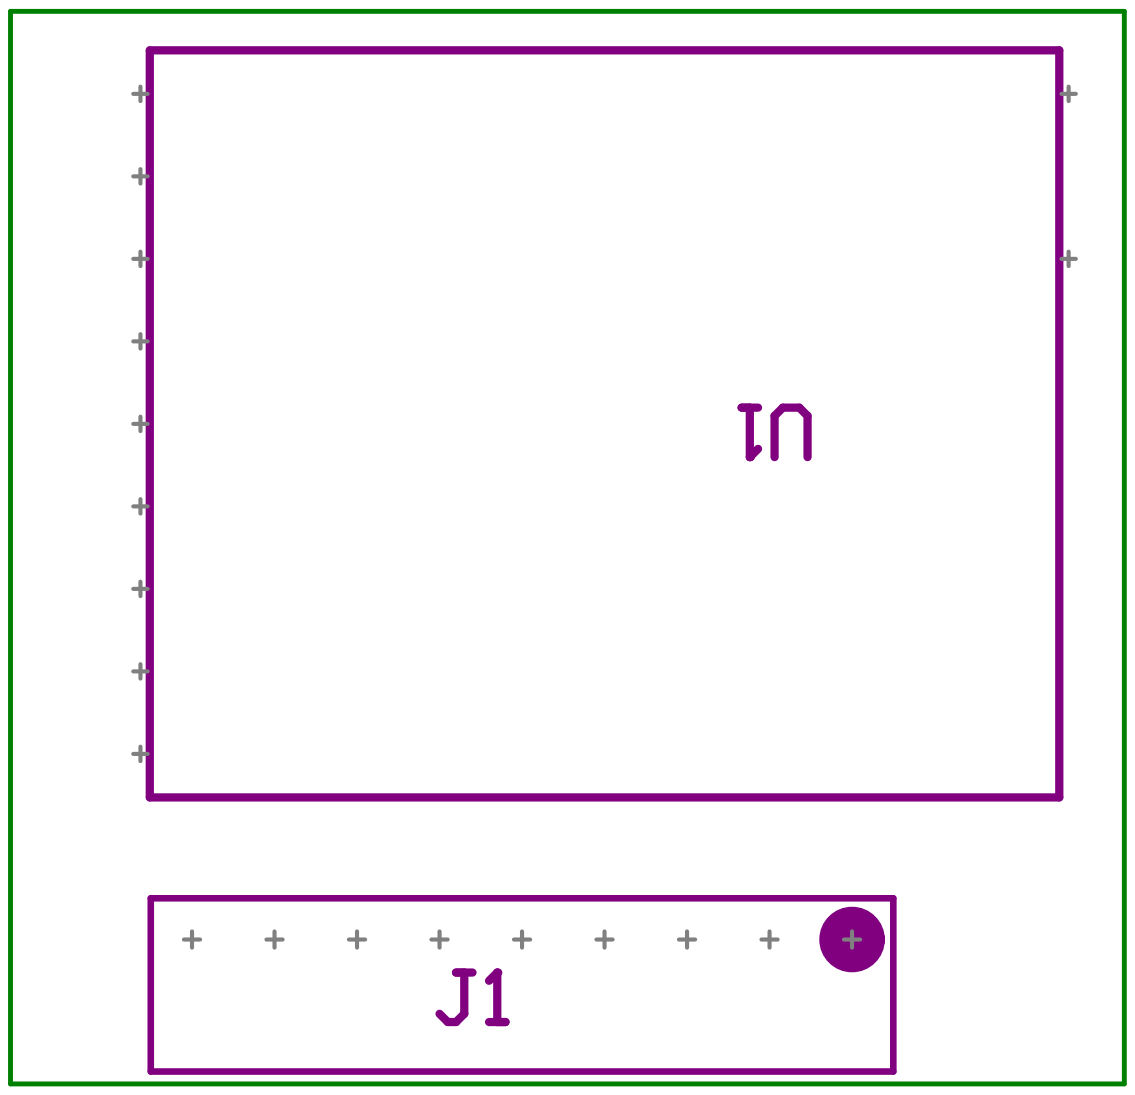
[picture p88: page 13]

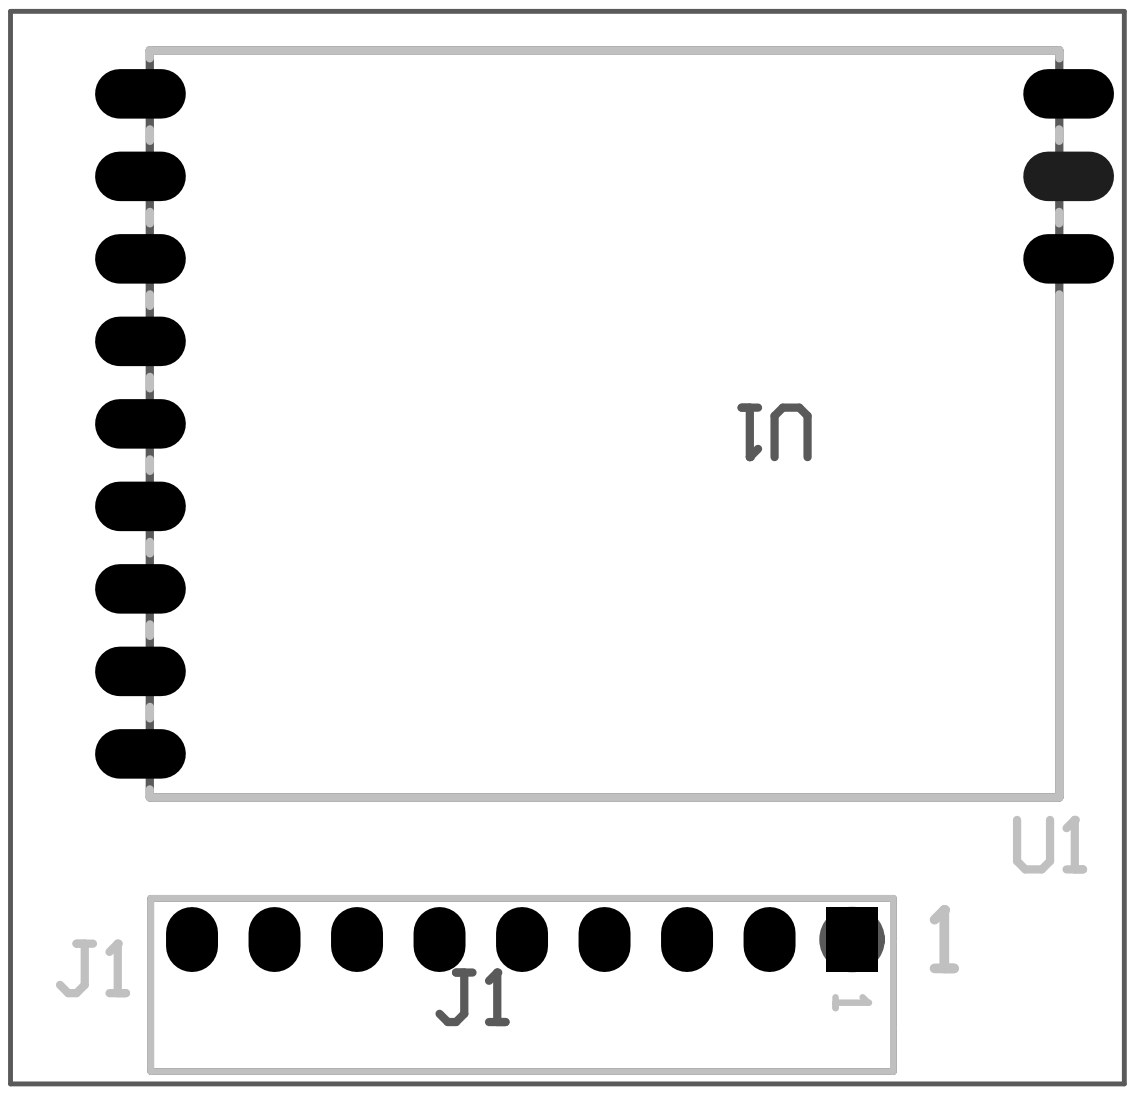
[picture p89: page 15]

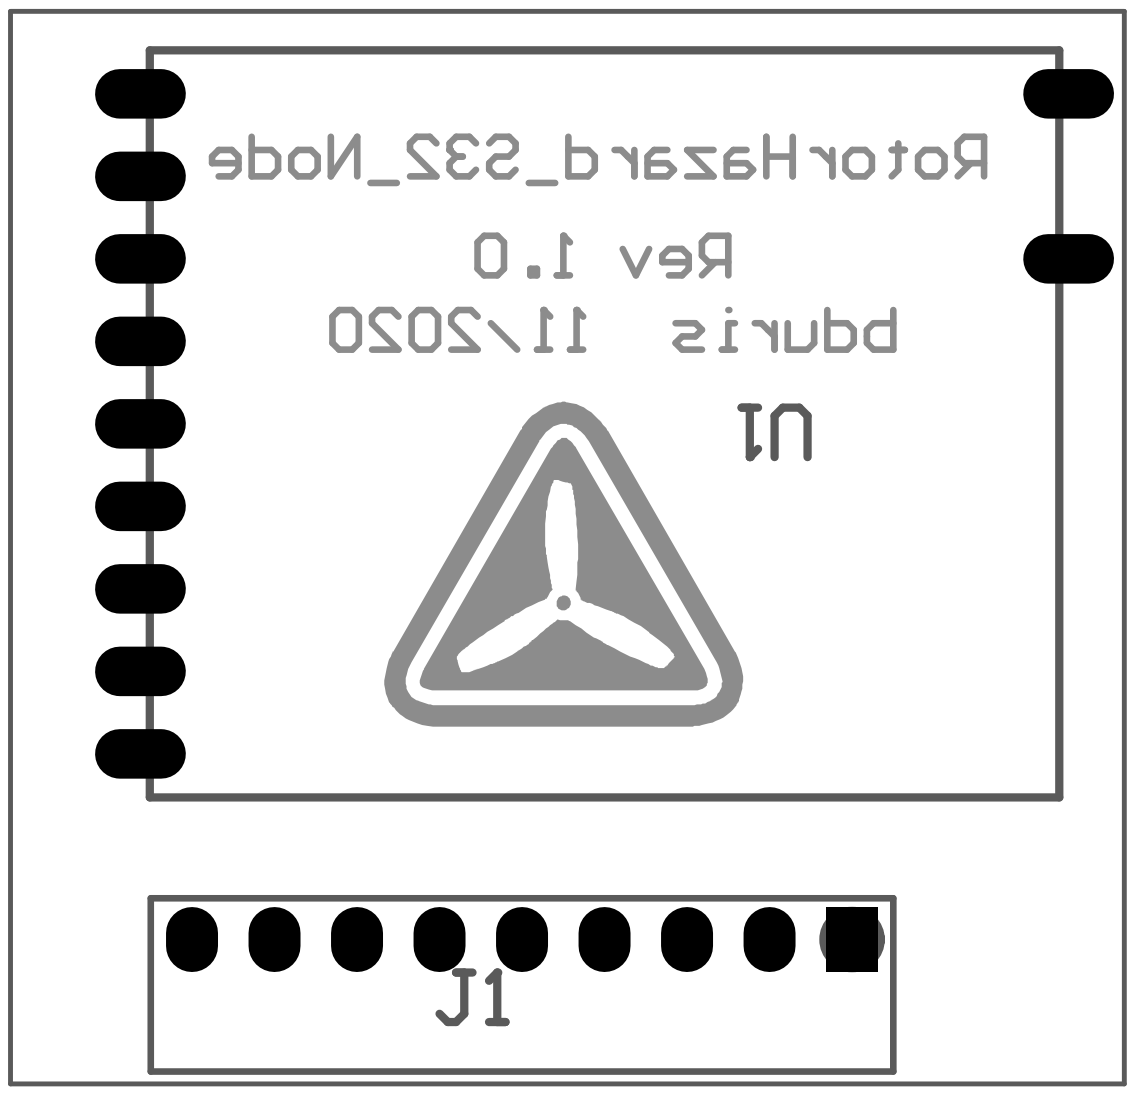
[picture p90: page 16]
