RotorHazard/rhfiles/(commit log)

2021-02-05 Added PCB PDFs and node_board_assy.pdf
2021-02-14 Added S32_BPill case design and build files
    [RotorHazardCaseBDyy.FCStd, RotorHazardCaseTopBDyy.stl]
2021-02-20 Added build image files for 6 node STM32
2021-03-14 6 node case files added (#2)
    * Added 3D files & images
    lid & LED panel to follow
    * lid & led panel files added, file names updated
    * Revert "lid & led panel files added, file names updated"
    This reverts commit 52988244c76835678f688f2f3971c9f02add958e.
    * Revert "Revert "lid & led panel files added, file names updated""
    This reverts commit 4ef4c3035f2d34dd1f223a9a5a61b08da7c12328.
    * Added images for case
    by Aaronsss
    [RotorHazard_Antenna_Holder_50mm.skp, RotorHazard_Antenna_Holder_50mm.stl, RotorHazard_Case.skp, RotorHazard_Case.stl, RotorHazard_LED_Cartridge.skp, RotorHazard_LED_Cartridge.stl, RotorHazard_Leg_60mm.skp, RotorHazard_Leg_60mm.stl]
2021-03-21 Case Image sizes updated
2021-04-22 Raspberry Pi Zero Files
    Added:
    Case without USB & ethernet cut-outs
    A taller standoff when not passing the screws through he Pi PCB
    [RotorHazard_Case - pi zero.skp, RotorHazard_Case - pi zero.stl, RotorHazard_Standoff_M3_13.1mm.skp, RotorHazard_Standoff_M3_13.1mm.stl]
2021-05-03 Added pics for stm32f4module.md
